teamprof/github-we2-doorbell/doc/we2-esp32c3-sch-v1.0.pdf

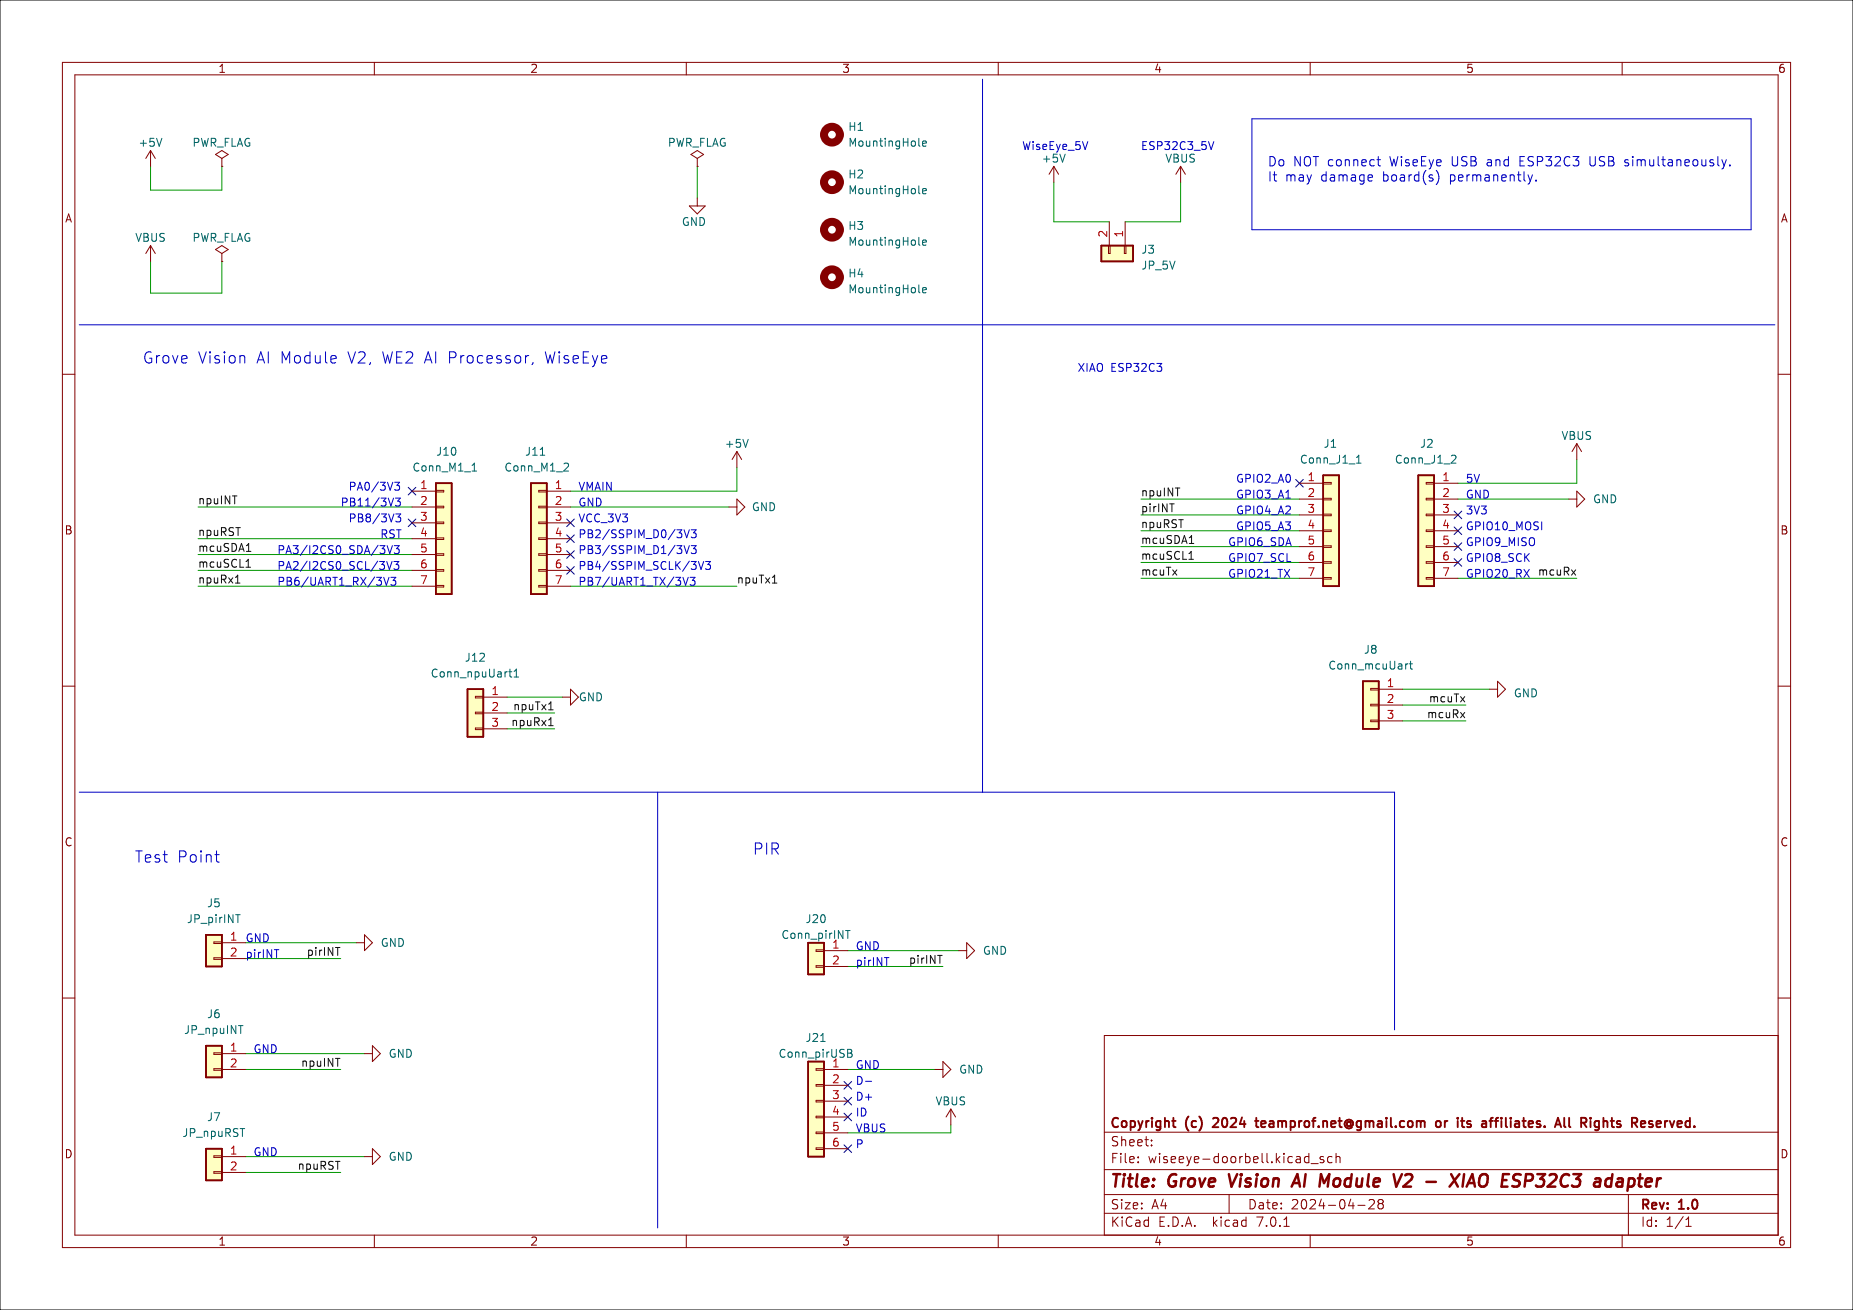
[picture p12: page 1]
