teamprof/github-we2-doorbell/(notices)

Notices in the files:
README.md:
License: GPL v3
