teamprof/github-we2-doorbell/doc/image/hw-front.jpg

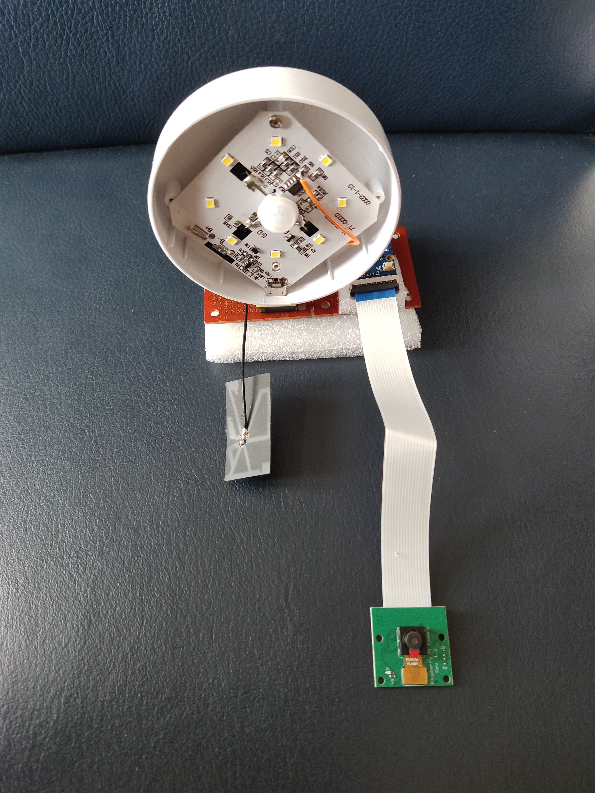
[picture p4: doc/image/hw-front.jpg]
doc/image/hw-front.jpg
